Sayantanmukhuti/omni/Hardware/Basic/Milestones-Exhaustive-BOM.xlsx

Milestones Exhuastive BOM |  |  |  |  |  |  |  |  |  |  | Total | $742.06
BOM # | Comment | Designator | Description | Mounting Type | Package | Manufacturer | Manufacturer Part Number | Supplier | Supplier Part Number | Price per unit | Quantity | Total
 | DigiKey
1 | NRF52832_MODULE_MDBT42 |  | Bluetooth Bluetooth v4.2 Transceiver Module 2.4GHz Integrated, Chip Surface Mount | SMD | 41-SMD Module | Seeed Technology Co., Ltd | 317030213 | Digi-Key | 1597-1434-ND | $10.10 | 6 | $60.60
2 | ATmega328 |  | AVR AVR® ATmega Microcontroller IC 8-Bit 20MHz 32KB (16K x 16) FLASH 32-TQFP (7x7) | SMD | 32-TQFP (7x7) | Microchip Technology | ATMEGA328P-AUR | Digi-Key | ATMEGA328P-AURCT-ND | $2.14 | 1 | $2.14
3 | 0.96" OLED | OLED | Datasheet 128x64 OLED Module SPI 0.96"Graphic Displays,White on Black | SMD | Flexible Connector | EastRising | https://www.buydisplay.com/datasheet-128x64-oled-module-spi-0-96-inch-graphic-displays-white-on-black | BuyDisplay.com | https://www.buydisplay.com/datasheet-128x64-oled-module-spi-0-96-inch-graphic-displays-white-on-black | $2.51 | 1 | $75.30
4 | 8x8 Bright Blue LED Matrix | MATRIX | Small 1.2" 8x8 Ultra Bright Blue LED Matrix - KWM-30881CBB | THT | 16-Pin THT | Luckylight | KWM-30881CBB | Adafruit Industries | 1047 | $5.95 | 1 | $5.95
5 | FT231XS USB Serial |  | USB Bridge, USB to UART USB 2.0 UART Interface 20-SSOP | SMD | 20-SSOP | FTDI, Future Technology Devices International Ltd | FT231XS-U | Digi-Key | 768-1156-5-ND | $2.12 | 6 | $12.72
6 | FTDI |  | USB Bridge, USB to UART USB 2.0 UART Interface 20-SSOP | SMD | 20-SSOP | FTDI, Future Technology Devices International Ltd | FT231XS-U | Digi-Key | 768-1156-5-ND | $2.12 | 1 | $2.12 | $1.98 | $1.98
7 | CP2102N |  | USB Bridge, USB to UART USB 2.0 UART Interface 24-QFN (4x4) | SMD | 24-WFQFN (4mm x 4mm) Exposed Pad | Silicon Labs | CP2102N-A02-GQFN24 | Digi-Key | CP2102N-A02-GQFN24 | $1.35 | 1 | $1.35 | $1.25 | $1.25
8 | 350 mAh LiPo Battery |  | 3.7V Lithium Polymer Battery Rechargeable (Secondary) 350mAh | JST | JST PH Connector | Adafruit Industries LLC | 4237 | Digi-Key | 1528-4237-ND | $5.95 | 3 | $17.85
9 | 290 mAh LiPo Battery |  | 3.7V Lithium-Ion Battery Rechargeable (Secondary) 290mAh | JST | JST PH Connector | TinyCircuits | ASR00007 | Digi-Key | 1832-1032-ND | $5.95 | 3 | $17.85
10 | 350 mAh LiPo Battery |  | 3.7V Lithium-Ion Battery Rechargeable (Secondary) 350mAh | JST | JST PH Connector | Adafruit Industries LLC | 2750 | Digi-Key | 1528-1858-ND | $6.95 | 3 | $20.85
11 | 9V Battery Connector | 9V | Battery Connector, Snap 9V 1 Cell Wire Leads - 4" (101.6mm) | THT |  | Keystone Electronics | 81-4 | Digi-Key | 36-81-4-ND | $0.55 | 1 | $0.55 | $0.40 | $0.40
12 | PAM2401 Boost Converter |  | Boost Switching Regulator IC Positive Adjustable 2.5V 1 Output 1A 8-TSSOP, 8-MSOP (0.118", 3.00mm Width) | SMD | 8-MSOP | Diodes Incorporated | PAM2401SCADJ | Digi-Key | PAM2401SCADJDICT-ND | $1.05 | 1 | $1.05 | $0.68 | $0.68
13 | AP7312 1.8V/3.3V Dual LDO |  | Linear Voltage Regulator IC 2 Output 150mA, 150mA SOT-26 | SMD | SOT-23-6 | Diodes Incorporated | AP7312-1833W6-7 | Digi-Key | AP7312-1833W6-7DICT-ND | $0.59 | 1 | $0.59 | $0.37 | $0.37
14 | MIC5504-1.8V |  | Linear Voltage Regulator IC 1 Output 300mA SOT-23-5 | SMD | SOT23-5 | Microchip Technology | MIC5504-1.8YM5-TR | Digi-Key | 576-4879-1-ND | $0.11 | 1 | $0.11 | $0.08 | $0.08
15 | MIC5504-3.3V |  | Linear Voltage Regulator IC 1 Output 300mA SOT-23-5 | SMD | SOT23-5 | Microchip Technology | MIC5504-3.3YM5-TR | Digi-Key | 576-4764-1-ND | $0.11 | 1 | $0.11 | $0.08 | $0.08
16 | MIC5504 Voltage Regulator |  | Linear Voltage Regulator IC 1 Output 300mA SOT-23-5 | SMD | SOT23-5 | Microchip Technology | MIC5504-3.3YM5-TR | Digi-Key | 576-4764-1-ND | $0.11 | 10 | $1.10
17 | MCP73831 T Li-Ion, Li-Pol Controller |  | Charger IC Lithium-Ion/Polymer SOT-23-5 | SMD | SOT-23-5 | Microchip Technology | MCP73831T-2ACI/OT | Digi-Key | MCP73831T-2ACI/OTCT-ND | $0.56 | 10 | $5.60
18 | FT24C64A EEPROM |  | EEPROM Memory IC 64Kb (8K x 8) I²C 800kHz 1.2µs 8-SOP | SMD | 8-SOP | Fremont Micro Devices Ltd | FT24C64A-ESR-T | Digi-Key | 1219-1220-1-ND | $0.20 | 6 | $1.20
19 | LM358 |  | General Purpose Amplifier 2 Circuit 8-SOIC | SMD | 8-SOIC | Texas Instruments | LM358DR | Digi-Key | 296-1014-1-ND | $0.38 | 1 | $0.38 | $0.14 | $0.14
20 | MCP6001 |  | General Purpose Amplifier 1 Circuit Rail-to-Rail SOT-23-5 | SMD | SOT-23-5 | Microchip Technology | MCP6001T-E/OTCT-ND | Digi-Key | MCP6001T-E/OTCT-ND | $0.29 | 1 | $0.29 | $0.22 | $0.22
21 | Op Amp - MCP6004 |  | General Purpose Amplifier 4 Circuit Rail-to-Rail 14-SOIC | SMD | 14-SOIC | Microchip Technology | MCP6004T-I/SL | Digi-Key | MCP6004T-I/SLCT-ND | $0.44 | 6 | $2.64
22 | TIA |  | General Purpose Amplifier 1 Circuit Rail-to-Rail SOT-23-5 | SMD | SOT-23-5 | Microchip Technology | MCP6001T-I/OT | Digi-Key | MCP6001T-I/OTCT-ND | $0.24 | 6 | $1.44
23 | PCF8574 |  | I/O Expander 8 I²C 100kHz 16-SO | SMD | 16-SO | NXP USA Inc. | PCF8574AT/3,518 | Digi-Key | 568-1074-1-ND | $1.53 | 1 | $1.53
24 | Potentiometer |  | 500k Ohm 1 Gang Linear Panel Mount Potentiometer None 1 Kierros Conductive Plastic 0.25W, 1/4W PC Pins | THT | Panel Mount | Bourns Inc. | 3310Y-001-504L | Digi-Key | 3310Y-001-504L-ND | $2.90 | 1 | $2.90 | $2.11 | $2.11
25 | Potentiometer |  | 1M Ohm 1 Gang Linear Through Hole Potentiometer None 1 Kierros Carbon 0.08W PC Pins | THT | THT | Bourns Inc. | PDB12-M4251-105BF | Digi-Key | PDB12-M4251-105BF-ND | $1.02 | 1 | $1.02 | $0.75 | $0.75
26 | AD5242 |  | Digital Potentiometer 1M Ohm 2 Circuit 256 Taps I²C Interface 16-SOIC | SMD | 16-SOIC | Analog Devices Inc. | AD5242BRZ1M | Digi-Key | AD5242BRZ1M-ND | $3.47 | 6 | $20.82
27 | PCF8523 |  | Real Time Clock (RTC) IC Clock/Calendar I²C, 2-Wire Serial 8-SOIC (0.154", 3.90mm Width) | SMD | 8-SO | NXP USA Inc. | PCF8523T/1,118 | Digi-Key | 568-5306-1-ND | $1.26 | 6 | $7.56
28 | NPN-Generic |  | Bipolar (BJT) Transistor NPN 40V 600mA 300MHz 250mW Surface Mount TO-236AB | SMD | TO-236AB | Nexperia USA Inc. | PMBT2222A,215 | Digi-Key | 1727-2956-1-ND | $1.05 | 10 | $10.50
29 | NFET |  | N-Channel 30V 500mA (Ta) 690mW (Ta) Surface Mount SOT-23-3 (TO-236) | SMD | SOT23-3 | ON Semiconductor | NTR4003NT3G | Digi-Key | NTR4003NT3GOSCT-ND | $0.27 | 3 | $0.81 | $0.09 | $0.28
30 | CRYSTALECS-.327-12.5-12-C-TR (CRYSTAL) (32.7680kHz) |  | 32.768kHz ±10ppm Crystal 12.5pF 90 kOhms 2-SMD, No Lead | SMD | 2-SMD, No Lead | ECS Inc. | ECS-.327-12.5-12-C-TR | Digi-Key | XC2288CT-ND | $0.60 | 10 | $5.98
31 | 8 MHz Crystal (THT) |  | 8.388MHz ±30ppm Crystal 18pF 80 Ohms Cylindrical Can, Radial | THT | Cylindrical Can, Radial | EPSON | CA-301 8.388608M-C: PB FREE | Digi-Key | SER3415-ND | $0.83 | 1 | $0.83 | $0.61 | $0.61
32 | 8 MHz Crystal (SMD) |  | 8MHz ±30ppm Crystal 20pF 800 Ohms 4-SMD, No Lead | SMD | 4-SMD, No Lead | Raltron Electronics | RH100-8.000-20-3050-EXT-TR | Digi-Key | 2151-RH100-8.000-20-3050-EXT-TRCT-ND | $0.68 | 1 | $0.68 | $0.49 | $0.49
33 | 12.288 MHz Crystal (SMD) |  | 12.288MHz ±10ppm Crystal 20pF 150 Ohms 4-SMD, No Lead | SMD | 4-SMD.NO LEAD | Diodes Incorporated | FH1220004 | Digi-Key | FH1220004DICT-ND | $0.73 | 1 | $0.73 | $0.49 | $0.49
34 | 12.288 MHz Crystal (THT) |  | 12.288MHz ±30ppm Crystal 18pF 50 Ohms Cylindrical Can, Radial | THT | Cylindrical Can, Radial | EPSON | CA-301 12.2880M-C:PBFREE | Digi-Key | SER3426-ND | $0.83 | 1 | $0.83 | $0.61 | $0.61
35 | Cortex Debug Connector - 10 pin |  | Connector Header Through Hole 10 position 0.050" (1.27mm) | THT | NA | Amphenol ICC (FCI) | 20021111-00010T4LF | Digi-Key | 609-3712-ND | $0.69 | 6 | $4.14
36 | Schottky Diode |  | Diode Schottky 30V 1.5A Surface Mount USC | SMD | USC | Toshiba Semiconductor and Storage | CUS15S30,H3F | Digi-Key | CUS15S30H3FCT-ND | $0.26 | 25 | $6.40
37 | Green LED | LED1 | Green 525nm LED Indication - Discrete 3.1V 0805 (2012 Metric) | SMD | 0805 | QT Brightek (QTB) | QBLP631-IG | Digi-Key | 1516-1084-1-ND | $0.39 | 1 | $0.39
38 | Red LED |  | Red 622nm LED Indication - Discrete 2.2V 0603 (1608 Metric) | SMD | 0603 | Inolux | IN-S63ATR | Digi-Key | 1830-1065-1-ND | $0.18 | 20 | $3.54
39 | Blue LED |  | Blue 470nm LED Indication - Discrete 3V 0603 (1608 Metric) | SMD | 0603 | Inolux | IN-S63AT5B | Digi-Key | 1830-1061-1-ND | $0.18 | 20 | $3.54
40 | Yellow LED |  | Yellow 590nm LED Indication - Discrete 2V 0603 (1608 Metric) | SMD | 0603 | Wurth Electronics Inc. | 150060YS75000 | Digi-Key | 732-4981-1-ND | $0.14 | 20 | $2.80
41 | White LED | LED1 | White LED Indication - Discrete 2.9V Radial | THT | Radial | American Bright Optoelectronics Corporation | BL-BZX3V4V-1-B02 | Digi-Key | BL-BZX3V4V-1-B02-ND | $0.26 | 1 | $0.26 | $0.09 | $0.09
42 | DotStar LED Matrix |  | SparkFun LuMini LED Matrix | SMD | Unspecified | SparkFun Electronics | COM-15047 | Digi-Key | 1568-COM-15047-ND | $25.95 | 1 | $25.95 | $25.95 | $25.95
43 | 16-Channel Multiplexer |  | Circuit IC Switch 16:1 160Ohm 24-SOIC | SMD | 24-SOIC | Texas Instruments | CD74HC4067M96 | Digi-Key | 296-29408-1-ND | $0.80 | 1 | $0.80 | $0.54 | $0.54
44 | 16-Channel Multiplexer |  | Circuit IC Switch 16:1 160Ohm 24-SSOP | SMD | 24-SSOP | Texas Instruments | CD74HC4067SM96E4 | Digi-Key | 296-52634-1-ND | $0.83 | 1 | $0.83 | $0.56 | $0.56
45 | PCF8575DWR |  | I/O Expander 16 I²C, SMBus 24-SOIC | SMD | 24-SOIC | Texas Instruments | PCF8575DWR | Digi-Key | 296-20981-1-ND | $2.52 | 1 | $2.52 | $1.82 | $1.82
46 | PCF8574ADWR |  | I/O Expander 8 I²C 16-SOIC | SMD | 16-SOIC | Texas Instruments | PCF8574DWR | Digi-Key | 296-13108-1-ND | $1.72 | 1 | $1.72 | $1.12 | $1.12
47 | Rotary Encoder |  | Rotary Encoder Mechanical 12 Quadrature (Incremental) Right Angle | THT | PC Pins | Bourns Inc. | PEC09-2220F-S0012 | Digi-Key | PEC09-2220F-S0012-ND | $3.16 | 1 | $3.16 | $2.15 | $2.15
48 | Electret Microphone | MIC | 100Hz ~ 10kHz Analog Microphone Electret Condenser Omnidirectional (-42dB ±3dB @ 94dB SPL) PC Pins | THT | PC Pins | CUI Devices | CMEJ-0415-42-P | Digi-Key | 102-6542-ND | $0.40 | 1 | $0.40 | $0.28 | $0.28
49 | Photodiode | PD | Photodiode 940nm 100ns 130° 2-SMD, Gull Wing, PHOTODIODE PIN HI SPEED HI SENS | SMD | 2-SMD, Gull Wing | Vishay Semiconductor Opto Division | VBPW34S | Digi-Key | 751-1500-1-ND | $1.19 | 1 | $1.19
50 | Photoresistor | Photo | CDS Cell 520nm 27 ~ 60kOhms @ 10 lux | THT | Radial | Advanced Photonix | PDV-P8104 | Digi-Key | PDV-P8104-ND | $0.89 | 1 | $0.89 | $0.46 | $0.46
51 | Ambient Light Sensor |  | Optical Sensor Ambient 630nm Analog 0603 (1608 Metric) | SMD | 0603 | Inolux | IN-S63DTLS | Digi-Key | 1830-IN-S63DTLSCT-ND | $0.55 | 1 | $0.55 | $0.26 | $0.26
52 | Thermistor |  | NTC Thermistor 10k 0603 (1608 Metric) | SMD | 0603 | Murata Electronics | NCU18XH103F60RB | Digi-Key | 490-16279-1-ND | $0.12 | 1 | $0.12 | $0.06 | $0.06
53 | Thermistor |  | NTC Thermistor 10k 0402 (1005 Metric) | SMD | 0402 | TDK Corporation | NTCG103JF103FT1 | Digi-Key | 445-2550-1-ND | $0.10 | 1 | $0.10 | $0.06 | $0.06
54 | 2.1 uH NFC Antenna |  | NFC ANTENNA 15.00MM BY 15.00MM B |  |  | Molex | 1462360151 | Digi-Key | 900-1462360151-ND | $1.38 | 2 | $2.76
55 | SWITCH.MOM (TACTILE_SWITCH_SMD_6.2MM_TALL) |  | Tactile Switch SPST-NO Top Actuated Surface Mount - TACT 4.5 X 4.5, 3.8 MM H, 1.8N, | SMD | Gull Wing | C&K | PTS 647 SM38 SMTR2 LFS | Digi-Key | PTS647SM38SMTR2LFSCT-ND | $0.12 | 25 | $3.02
56 | SWITCH.MOM (TACTILE_SWITCH_SMD_6.2MM_TALL) |  | Tactile Switch SPST-NO Top Actuated Surface Mount - TACT 4.5 X 4.5, 5.0 MM H, 1.0N, | SMD | Gull Wing | C&K | PTS 647 SN50 SMTR2 LFS | Digi-Key | PTS647SN50SMTR2LFSCT-ND | $0.12 | 25 | $3.02
57 | SWITCH.MOM (TACTILE_SWITCH_SMD_6.2MM_TALL) |  | Tactile Switch SPST-NO Top Actuated Surface Mount - TACT 4.5 X 4.5, 7.0 MM H, 1.0N, | SMD | Gull Wing | C&K | PTS 647 SN70 SMTR2 LFS | Digi-Key | PTS647SN70SMTR2LFSCT-ND | $0.12 | 25 | $3.02
58 | DFU SPST-PTS830GG140 |  | Tactile Switch SPST-NO Top Actuated Surface Mount | SMD | Gull Wing | C&K Components | PTS830GM140 SMTR LFS | Digi-Key | CKN10587CT-ND | $0.53 | 25 | $13.14
59 | Micro USB |  | USB - micro B USB 2.0 Receptacle Connector 5 Position Surface Mount, Right Angle | SMD | Flange, Horizontal | Amphenol FCI | 10118192-0001LF | Digi-Key | 609-4613-1-ND | $0.43 | 10 | $4.30
60 | SD Card Slot |  | 8 Position Card Connector Secure Digital - microSD™ Surface Mount, Right Angle Gold | SMD | NA | Molex | 0473340001 | Digi-Key | WM3288CT-ND | $3.64 | 5 | $18.20
61 | 2x3 Male Pin Headers |  | Connector Header Through Hole 6 position 0.100" (2.54mm) | THT |  | Adam Tech | PH2-06-UA | Digi-Key | 2057-PH2-06-UA-ND | $0.12 | 1 | $0.12 | $0.07 | $0.07
62 | CONN_07-1.27MM (CONN_07) |  | 50 Position Header Connector 0.050" (1.27mm) Through Hole Gold | THT |  | Sullins Connector Solutions | LPPB501NFFN-RC | Digi-Key | S9008E-50-ND | $5.06 | 5 | $25.30
63 | CONN_07-1.27MM |  | 50 Positions Header Connector 0.050" (1.27mm) Through Hole Gold | THT |  | Sullins Connector Solutions | GRPB501VWVN-RC | Digi-Key | S9014E-50-ND | $3.11 | 5 | $15.55
64 | Bigger Button |  | Tactile Switch SPST-NO Top Actuated Surface Mount | SMD | Gull Wing | C&K | PTS645SM43SMTR92 LFS | Digi-Key | CKN9112CT-ND | $0.25 | 1 | $0.25 |  | $0.00
65 | Tiny Rectangular Switch |  | Tactile Switch SPST-NO Top Actuated Surface Mount | SMD | Gull Wing | C&K Components | PTS830GM140 SMTR LFS | Digi-Key | CKN10587CT-ND | $0.57 | 1 | $0.57 |  | $0.00
66 | SAM-M8Q U-Blox GPS |  | SAM-M8Q RF Receiver Galileo, GLONASS, GPS 1.575GHz, 1.602GHz -165dBm 400kbps | SMD | Module | U-Blox | SAM-M8Q-0-10 | Digi-Key | 672-1054-1-ND | $25.00 | 1 | $25.00 | $13.26 | $13.26
67 | GP-20U7 GPS Module |  | GPS Modules GPS Receiver GP-20U7 | SMD | Module | SparkFun | GPS-13740 | Mouser | 474-GPS-13740 | $19.04 | 1 | $19.04 | $19.04 | $19.04
68 | Mini Speaker |  | 8 Ohms General Purpose Speaker 500mW 300Hz ~ 8kHz Top Round | THT | Wire Leads | Soberton Inc. | SP-1303L | Digi-Key | 433-1204-ND | $1.71 | 1 | $1.71 | $1.16 | $1.16
69 | Vibration Motor |  | DC Motor Vibration, ERM 10000 RPM 3VDC | THT | Wire Leads | Jinlong Machinery & Electronics, Inc. | C0720B015F | Digi-Key | 1670-1030-ND | $3.54 | 1 | $3.54 | $2.61 | $2.61
70 | 10µH Inductor |  | 10µH Shielded Multilayer Inductor 250mA 1.05Ohm 0603 (1608 Metric) | SMD | 0603 | TDK Corporation | MLZ1608M100WTD25 | Digi-Key | MLZ1608M100WTD25 | $0.22 | 1 | $0.22 | $0.13 | $0.13
71 | 10µH Inductor |  | 10µH Shielded Multilayer Inductor 350mA 470mOhm 0805 (2012 Metric) | SMD | 0805 | TDK Corporation | MLZ2012M100WT000 | Digi-Key | 445-6396-1-ND | $0.14 | 1 | $0.14 | $0.09 | $0.09
72 | 0 ohm resistor (not sure if needed) |  | 0 Ohms Jumper 0.1W, 1/10W Chip Resistor 0603 (1608 Metric) Moisture Resistant Thick Film | SMD | 0603 | Yageo | RC0603JR-070RL | Digi-Key | 311-0.0GRCT-ND | $0.01 | 100 | $0.70
73 | 27 ohm resistor |  | 27 Ohms ±1% 0.1W, 1/10W Chip Resistor 0603 (1608 Metric) Automotive AEC-Q200 Thick Film | SMD | 0603 | Stackpole Electronics Inc | RMCF0603FT27R0 | Digi-Key | RMCF0603FT27R0CT-ND | $0.01 | 100 | $0.59
74 | 1k Resistor |  | 1 kOhms ±1% 0.1W, 1/10W Chip Resistor 0603 (1608 Metric) Automotive AEC-Q200 Thick Film | SMD | 0603 | Stackpole Electronics Inc | RMCF0603FT1K00 | Digi-Key | RMCF0603FT1K00CT-ND | $0.01 | 100 | $0.59
75 | 4.7k resistor |  | 4.7 kOhms ±1% 0.1W, 1/10W Chip Resistor 0603 (1608 Metric) Automotive AEC-Q200 Thick Film | SMD | 0603 | Stackpole Electronics Inc | RMCF0603FT4K70 | Digi-Key | RMCF0603FT4K70CT-ND | $0.01 | 100 | $0.59
76 | 10k Resistor |  | 10 kOhms ±1% 0.1W, 1/10W Chip Resistor 0603 (1608 Metric) Automotive AEC-Q200 Thick Film | SMD | 0603 | Stackpole Electronics Inc | RMCF0603FT10K0 | Digi-Key | RMCF0603FT10K0CT-ND | $0.01 | 100 | $0.59
77 | 100k Resistor |  | 100 kOhms ±1% 0.1W, 1/10W Chip Resistor 0603 (1608 Metric) Automotive AEC-Q200 Thick Film | SMD | 0603 | Stackpole Electronics Inc | RMCF0603FT100K | Digi-Key | RMCF0603FT100KCT-ND | $0.01 | 100 | $0.59
78 | 220k resistor |  | 220 kOhms ±1% 0.1W, 1/10W Chip Resistor 0603 (1608 Metric) Automotive AEC-Q200 Thick Film | SMD | 0603 | Stackpole Electronics Inc | RMCF0603FT220K | Digi-Key | RMCF0603FT220KCT-ND | $0.01 | 100 | $0.59
79 | 390k resistor |  | 390 kOhms ±1% 0.1W, 1/10W Chip Resistor 0603 (1608 Metric) Automotive AEC-Q200 Thick Film | SMD | 0603 | Stackpole Electronics Inc | RMCF0603FG390K | Digi-Key | RMCF0603FG390KCT-ND | $0.01 | 100 | $0.59
80 | 1M Resistor |  | 1 MOhms ±1% 0.1W, 1/10W Chip Resistor 0603 (1608 Metric) Automotive AEC-Q200 Thick Film | SMD | 0603 | Stackpole Electronics Inc | RMCF0603FT1M00 | Digi-Key | RMCF0603FT1M00CT-ND | $0.01 | 100 | $0.59
81 | 10M Resistor |  | 10 MOhms ±1% 0.1W, 1/10W Chip Resistor 0603 (1608 Metric) Automotive AEC-Q200 Thick Film | SMD | 0603 | Stackpole Electronics Inc | RMCF0603FT10M0 | Digi-Key | RMCF0603FT10M0CT-ND | $0.01 | 100 | $0.89
82 | 22M Resistor |  | 22 MOhms ±5% 0.1W, 1/10W Chip Resistor 0603 (1608 Metric) Automotive AEC-Q200, Moisture Resistant Thick Film | SMD | 0603 | KOA Speer Electronics, Inc. | RK73B1JTTD226J | Digi-Key | 2019-RK73B1JTTD226JCT-ND | $0.01 | 100 | $0.53
83 | 12pF capacitor |  | 12pF ±5% 50V Ceramic Capacitor C0G, NP0 0603 (1608 Metric) | SMD | 0603 | Walsin Technology Corporation | 0603N120J500CT | Digi-Key | 1292-1480-1-ND | $0.01 | 100 | $1.19
84 | 18pF capacitor |  | 18pF ±5% 50V Ceramic Capacitor C0G, NP0 0603 (1608 Metric) | SMD | 0603 | Walsin Technology Corporation | 0603N180J500CT | Digi-Key | 1292-1494-1-ND | $0.10 | 1 | $0.10 | 0.0119 | 100
85 | 33pF capacitor |  | 33pF ±5% 50V Ceramic Capacitor C0G, NP0 0603 (1608 Metric) | SMD | 0603 | Walsin Technology Corporation | 0603N330J500CT | Digi-Key | 1292-1645-1-ND | $0.10 | 1 | $0.10 | 0.0119 | 100
86 | 47 pF Capacitor |  | 47pF ±5% 50V Ceramic Capacitor C0G, NP0 0603 (1608 Metric) | SMD | 0603 | Walsin Technology Corporation | 0603N470J500CT | Digi-Key | 1292-1528-1-ND | $0.01 | 100 | $1.10
87 | 120 pF Capacitor |  | 120pF ±5% 50V Ceramic Capacitor C0G, NP0 0603 (1608 Metric) | SMD | 0603 | Walsin Technology Corporation | 0603N121J500CT | Digi-Key | 1292-1481-1-ND | $0.02 | 100 | $1.75
88 | 2.2n Capacitor |  | 2200pF ±10% 50V Ceramic Capacitor X7R 0603 (1608 Metric) | SMD | 0603 | Walsin Technology Corporation | 0603B222K500CT | Digi-Key | 1292-1412-1-ND | $0.01 | 100 | $1.16
89 | 22n capacitor |  | 0.022µF ±10% 50V Ceramic Capacitor X7R 0603 (1608 Metric) | SMD | 0603 | Samsung Electro-Mechanics | CL10B223KB8NNNC | Digi-Key | 1276-1104-1-ND | $0.02 | 100 | $1.56
90 | 100 nF Capacitor |  | 0.1µF ±5% 16V Ceramic Capacitor X7R 0603 (1608 Metric) | SMD | 0603 | Yageo | CC0603JRX7R7BB104 | Digi-Key | 311-1776-1-ND | $0.03 | 100 | $3.31
91 | 1uF capacitor |  | 1µF ±10% 25V Ceramic Capacitor X5R 0603 (1608 Metric) | SMD | 0603 | Samsung Electro-Mechanics | CL10A105KA8NNNC | Digi-Key | 1276-1102-1-ND | $0.10 | 1 | $0.10 | $0.02 | $0.02
92 | 2.2u capacitor |  | 2.2µF ±10% 16V Ceramic Capacitor X5R 0603 (1608 Metric) | SMD | 0603 | Samsung Electro-Mechanics | CL10A225KO8NNNC | Digi-Key | 1276-1040-1-ND | $0.03 | 100 | $3.16 |  | $0.00
93 | 4.7 uF Capacitor |  | red 622nm LED Indication - Discrete 2.2V 0603 (1608 Metric) | SMD | 0603 | Samsung Electro-Mechanics | CL10A475KO8NNNC | Digi-Key | 1276-1784-1-ND | $0.04 | 100 | $4.40 |  | $0.00
94 | 10 uF 0603 Capacitor |  | 10µF ±10% 10V Ceramic Capacitor X5R 0603 (1608 Metric) | SMD | 0603 | Murata Electronics | GRM188R61A106KE69J | Digi-Key | 490-14372-1-ND | $0.06 | 100 | $6.32 |  | $0.00
95 | 22u capacitor |  | 22µF ±20% 10V Ceramic Capacitor X5R 0603 (1608 Metric) | SMD | 0603 | Samsung Electro-Mechanics | CL10A226MP8NUNE | Digi-Key | 1276-1274-1-ND | $0.07 | 100 | $6.72 |  | $0.00
96 | Adafruit Feather nRF52 |  | - Transceiver; Bluetooth® Smart 4.x Low Energy (BLE) For Use With nRF52832 | NA | NA | Adafruit Industries LLC | 3406 | Digi-Key | 1528-2095-ND | $24.95 | 3 | $74.85 |  | $0.00
97 | J-LINK EDU |  | JTAG EMULATOR FOR ARM CORES - ARM7®, ARM9®, Cortex® - Emulator | NA | NA | Segger Microcontroller Systems | 8.08.90 J-LINK EDU | Digi-Key | 899-1008-ND | $63.75 | 1 | $63.75 |  | $0.00
98 | J-LINK 9-PIN CORTEX-M ADAPTER |  | Cortex®-M Devices - Adapter Board - J-LINK 9-PIN CORTEX-M ADAPTER | NA | NA | Segger Microcontroller Systems | 8.06.02 J-LINK 9-PIN CORTEX-M ADAPTER | Digi-Key | 899-1012-ND | $31.88 | 1 | $31.88 |  | $0.00
99 |  |  |  |  |  |  |  |  |  |  |  |  |  | $0.00
100 | JST Connector |  | JST Right Angle Connector - White | SMD | NA | 4UCOM Technology Inc. |  | Sparkfun Electronics | PRT-08612 | $0.95 | 1 | $0.95 |  | $0.00 | $0.90 | $0.86 | $0.86 | $0.86 | $0.86 | $0.90 | $0.86 | $0.86 | $0.86 | $0.86 | $22.50 | $86.00 | $215.00 | $430.00 | $860.00
101 | Switch |  | SWITCH SLIDE DPDT 300MA 6V | SMD | J Lead | C&K | JS202011JCQN | Digi-Key | CKN10723CT-ND | $0.48 | 2 | $0.96 |  | $0.00 | $0.45 | $0.39 | $0.37 | $0.32 | $0.32 | $0.90 | $0.77 | $0.75 | $0.64 | $0.64 | $22.62 | $77.00 | $186.78 | $317.62 | $635.24
102 | Right Angle, 6Pos Male Headers |  | 40 Positions Header, Breakaway Connector 0.100" (2.54mm) Through Hole, Right Angle Gold | THT |  | Sullins Connector Solutions | PRPC040SBAN-M71RC | Digi-Key | S1111EC-40-ND | $0.14 | 1 | $0.14 |  | $0.00 | $0.12 | $0.10 | $0.10 | $0.08 | $0.07 | $0.12 | $0.10 | $0.10 | $0.08 | $0.07 | $3.08 | $10.14 | $25.36 | $40.09 | $68.83
103 | 8MHz Crystal |  | 8MHz ±30ppm Crystal 18pF 80 Ohm -20°C ~ 70°C Through Hole Cylindrical Can, Radial | THT | Cylindrical Can, Radial | EPSON | CA-301 8.0000M-C:PBFREE | Digi-Key | SER3414-ND | $0.83 | 1 | $0.83 |  | $0.00 | $0.74 | $0.61 | $0.61 | $0.58 | $0.48 | $0.74 | $0.61 | $0.61 | $0.58 | $0.48 | $18.40 | $60.80 | $152.00 | $288.00 | $480.00
104 | Square Button |  | Tactile Switch SPST-NO Top Actuated Surface Mount | SMD | Gull Wing | C&K | PTS645SM43SMTR92 LFS | Digi-Key | CKN9112CT-ND | $0.15 | 3 | $0.45 |  | $0.00 | $0.14 | $0.13 | $0.12 | $0.12 | $0.12 | $0.42 | $0.39 | $0.36 | $0.35 | $0.35 | $10.62 | $38.70 | $91.08 | $174.57 | $349.14
105 | Tiny Rectangular Button |  | Tactile Switch SPST-NO Top Actuated Surface Mount | SMD | Gull Wing | C&K Components | PTS830GM140 SMTR LFS | Digi-Key | CKN10587CT-ND | $0.56 | 1 | $0.56 |  | $0.00 | $0.53 | $0.44 | $0.40 | $0.38 | $0.30 | $0.53 | $0.44 | $0.40 | $0.38 | $0.30 | $13.34 | $44.29 | $100.65 | $191.24 | $301.95
106 | 5mm Radial Green LED, Diffused |  | Green 570nm LED Indication - Discrete 2.2V Radial | THT | Radial | Visual Communications Company - VCC | VAOL-5LDE1 | Digi-Key | VAOL-5LDE1-ND | $0.43 | 1 | $0.43 |  | $0.00 | $0.25 | $0.20 | $0.17 | $0.14 | $0.11 | $0.25 | $0.20 | $0.17 | $0.14 | $0.11 | $6.30 | $20.16 | $42.53 | $72.45 | $113.40
107 | Green LED |  | Green 571 nm, 2 V | SMD | 0603 | Lite-On Inc | LTST-C190KGKT | Digi-Key | 160-1435-1-ND | $0.27 | 3 | $0.81 |  | $0.00 | $0.14 | $0.10 | $0.07 | $0.06 | $0.05 | $0.43 | $0.31 | $0.21 | $0.19 | $0.15 | $10.86 | $31.02 | $52.74 | $93.06 | $145.80
108 | 2.2uF capacitor |  | 2.2µF ±10% 16V Ceramic Capacitor X5R 0603 (1608 Metric) | SMD | 0603 | Murata Electronics North America | GRM188R61C225KE15D | Digi-Key | 490-3296-1-ND | $0.13 | 2 | $0.26 |  | $0.00 | $0.09 | $0.04 | $0.04 | $0.03 | $0.03 | $0.19 | $0.09 | $0.09 | $0.06 | $0.05 | $4.70 | $8.80 | $22.00 | $30.86 | $51.10
109 |  |  |  |  |  |  |  |  |  |  |  |  |  | $0.00
110 | Red 8x8 LED Matrix |  | Small 1.2" 8x8 Ultra Bright Red LED Matrix - KWM-30881CVB | THT | 16-Pin THT | Luckylight | KWM-30881CVB | Adafruit Industries | 455 | $3.95 | 1 | $3.95 |  | $0.00 | $3.56 | $3.16 | $3.16 | $3.16 | $3.16
111 | Yellow-Orange LED Matrix |  | Small 1.2" 8x8 Ultra Bright Yellow-Orange LED Matrix - KWM-30881CUYB | THT | 16-Pin THT | Luckylight | KWM-30881CUYB | Adafruit Industries | 1046 | $4.50 | 1 | $4.50 |  | $0.00 | $4.05 | $3.60 | $3.60 | $3.60 | $3.60
112 | Yellow-Green LED Matrix |  | Small 1.2" 8x8 Ultra Bright Yellow-Green LED Matrix - KWM-30881CUGB | THT | 16-Pin THT | Luckylight | KWM-30881CUGB | Adafruit Industries | 1045 | $4.95 | 1 | $4.95 |  | $0.00 | $4.46 | $3.96 | $3.96 | $3.96 | $3.96
113 | White LED Matrix |  | Small 1.2" 8x8 Ultra Bright White LED Matrix - KWM-30881CWB | THT | 16-Pin THT | Luckylight | KWM-30881CWB | Adafruit Industries | 1613 | $7.50 | 1 | $7.50 |  | $0.00 | $6.75 | $6.00 | $6.00 | $6.00 | $6.00
114 | Green LED Matrix |  | Small 1.2" 8x8 Ultra Bright Pure Green LED Matrix - KWM-30881CPGB | THT | 16-Pin THT | Luckylight | KWM-30881CPGB | Adafruit Industries | 1623 | $4.95 | 1 | $4.95 |  | $0.00 | $4.46 | $3.96 | $3.96 | $3.96 | $3.96
115 | APDS-9008 |  | Optical Sensor Ambient 565nm Current 6-SMD, No Lead | SMD | 6-SMD, No Lead | Broadcom Limited | APDS-9008-020 | Digi-Key | 516-2662-1-ND | $1.04 | 1 | $4.95 | $0.70 | $0.70
 |  |  |  |  |  |  |  |  |  |  |  |  |  | $0.00
 |  |  |  |  |  |  |  |  |  |  |  |  |  | $0.00
 |  |  |  |  |  |  |  |  |  |  |  |  |  | $0.00
 |  |  |  |  |  |  |  |  |  |  |  |  |  | $0.00
 |  |  |  |  |  |  |  |  |  |  |  |  |  | $0.00
 |  |  |  |  |  |  |  |  |  |  |  |  |  | $0.00
 |  |  |  |  |  |  |  |  |  |  |  |  |  | $0.00
 |  |  |  |  |  |  |  |  |  |  |  |  |  | $0.00
 |  |  |  |  |  |  |  |  |  |  |  |  |  | $0.00
 | Mouser |  |  |  |  |  |  |  |  |  |  |  |  | $0.00
1 | AD5171 |  | Digital Potentiometer ICs IC 6-Bit OTP I2C | SMD | SOT-23-8 | Analog Devices | AD5171BRJZ100-R7 | Mouser | 584-AD5171BRJZ100-R7 | $2.68 | 5 | $13.40 |  | $0.00
 |  |  |  |  |  |  |  |  |  |  |  |  |  | $0.00
 |  |  |  |  |  |  |  |  |  |  |  |  |  | $0.00
 |  |  |  |  |  |  |  |  |  |  |  |  |  | $0.00
 | SparkFun Electronics |  |  |  |  |  |  |  |  |  |  |  |  | $0.00
1 | Mini Speaker |  | Mini Speaker - PC Mount 12mm 2.048kHz | THT | PC Mount | CUI Inc | COM-07950 | SparkFun Electronics | COM-07950 | $1.95 | 1 | $1.95 | $1.76 | $1.76
 |  |  |  |  |  |  |  |  |  |  |  |  |  | $0.00
 |  |  |  |  |  |  |  |  |  |  |  |  |  | $0.00
 |  |  |  |  |  |  |  |  |  |  |  |  |  | $0.00
 | Amazon |  |  |  |  |  |  |  |  |  |  |  |  | $0.00
1 | Red Laser | LASER | HiLetgo 10pcs 5V 650nm 5mW Red Dot Laser Head Red Laser Diode Laser Tube with Leads Head Outer Diameter 6mm | THT | Wire Leads | HiLetgo |  | HiLetgo on Amazon | B071FT9HSV | $0.55 | 1 | $0.55 | $0.55 | $0.55
 |  |  |  |  |  |  |  |  |  |  |  |  |  | $0.00
 |  |  |  |  |  |  |  |  |  |  |  |  |  | $0.00
 |  |  |  |  |  |  |  |  |  |  |  |  |  | $0.00
 | Custom Order |  |  |  |  |  |  |  |  |  |  |  |  | $0.00
1 | LSM6DS3 castellated breakout |  |  |  |  |  |  |  |  |  |  | $0.00 |  | $0.00
 |  |  |  |  |  |  |  |  |  |  |  |  |  | $0.00
 |  |  |  |  |  |  |  |  |  |  |  |  |  | $0.00
 |  |  |  |  |  |  |  |  |  |  |  |  |  | $0.00
 |  |  |  |  |  |  |  |  |  |  |  |  |  | $0.00
 |  |  |  |  |  |  |  |  |  |  |  |  |  | $0.00
 |  |  |  |  |  |  |  |  |  |  |  |  |  | $0.00
 |  |  |  |  |  |  |  |  |  |  |  |  |  | $0.00
 |  |  |  |  |  |  |  |  |  |  |  |  |  | $0.00
 |  |  |  |  |  |  |  |  |  |  |  |  |  | $0.00
