Sayantanmukhuti/omni/Hardware/Basic/Top/Omni-BASIC-TOP-BOM.xlsx

Omni Basic Top Board Rev A / Purdue Milestones |  |  |  |  |  |  |  |  |  |  | Total | $101.41 | Total (in Bulk) | $0.19
BOM # | Comment | Designator | Description | Mounting Type | Package | Manufacturer |  |  |  | Price per unit | Quantity | Total | Per 100 | Total
1 | 1uF capacitor | C1, C3, C6 | 1µF ±10% 25V Ceramic Capacitor X5R 0603 (1608 Metric) | SMD | 0603 | Samsung Electro-Mechanics |  |  |  | $0.10 | 3 | $0.30 | $0.02 | $0.06
2 | 4.7 uF Capacitor | C1, C7 | red 622nm LED Indication - Discrete 2.2V 0603 (1608 Metric) | SMD | 0603 | Samsung Electro-Mechanics |  |  |  | $0.04 | 2 | $0.09 |  | $0.00
3 | 10 uF 0603 Capacitor | C4, C16 | 10µF ±10% 10V Ceramic Capacitor X5R 0603 (1608 Metric) | SMD | 0603 | Murata Electronics |  |  |  | $0.06 | 2 | $0.13 |  | $0.00
4 | 12pF capacitor | C5, C8 | 12pF ±5% 50V Ceramic Capacitor C0G, NP0 0603 (1608 Metric) | SMD | 0603 | Walsin Technology Corporation |  |  |  | $0.01 | 2 | $0.02 |  | $0.00
5 | 47 pF Capacitor | C11, C13 | 47pF ±5% 50V Ceramic Capacitor C0G, NP0 0603 (1608 Metric) | SMD | 0603 | Walsin Technology Corporation |  |  |  | $0.01 | 2 | $0.02 |  | $0.00
6 | 100 nF Capacitor | C12, C14 | 0.1µF ±5% 16V Ceramic Capacitor X7R 0603 (1608 Metric) | SMD | 0603 | Yageo |  |  |  | $0.03 | 2 | $0.07 |  | $0.00
7 | 2.2u capacitor | C17, C18, C19, C20, C21 | 2.2µF ±10% 16V Ceramic Capacitor X5R 0603 (1608 Metric) | SMD | 0603 | Samsung Electro-Mechanics |  |  |  | $0.03 | 5 | $0.16 |  | $0.00
8 | MCP73831 T Li-Ion, Li-Pol Controller | CHRG1 | Charger IC Lithium-Ion/Polymer SOT-23-5 | SMD | SOT-23-5 | Microchip Technology |  |  |  | $0.56 | 1 | $0.56 |  | $0.00
9 | Schottky Diode | D1, D2, D3 | Diode Schottky 30V 1.5A Surface Mount USC | SMD | USC | Toshiba Semiconductor and Storage |  |  |  | $0.26 | 3 | $0.77 |  | $0.00
10 | Cortex Debug Connector - 10 pin | DEBUG1 CORTEX_DEBUG_PTH | Connector Header Through Hole 10 position 0.050" (1.27mm) | THT | NA | Amphenol ICC (FCI) |  |  |  | $0.69 | 1 | $0.69 |  | $0.00
11 | 10µH Inductor | L1 | 10µH Shielded Multilayer Inductor 250mA 1.05Ohm 0603 (1608 Metric) | SMD | 0603 | TDK Corporation |  |  |  | $0.22 | 1 | $0.22 | $0.13 | $0.13
12 | MIC5504 Voltage Regulator | LD01 | Linear Voltage Regulator IC 1 Output 300mA SOT-23-5 | SMD | SOT23-5 | Microchip Technology |  |  |  | $0.11 | 1 | $0.11 |  | $0.00
13 | Red LED | LED1, LED3 | Red 622nm LED Indication - Discrete 2.2V 0603 (1608 Metric) | SMD | 0603 | Inolux |  |  |  | $0.18 | 2 | $0.35 |  | $0.00
14 | Blue LED | LED2 | Blue 470nm LED Indication - Discrete 3V 0603 (1608 Metric) | SMD | 0603 | Inolux |  |  |  | $0.18 | 1 | $0.18 |  | $0.00
15 | Yellow LED | LED4 | Yellow 590nm LED Indication - Discrete 2V 0603 (1608 Metric) | SMD | 0603 | Wurth Electronics Inc. |  |  |  | $0.14 | 1 | $0.14 |  | $0.00
16 | 10k Resistor | R1, R2, R10, R13 | 10 kOhms ±1% 0.1W, 1/10W Chip Resistor 0603 (1608 Metric) Automotive AEC-Q200 Thick Film | SMD | 0603 | Stackpole Electronics Inc |  |  |  | $0.01 | 4 | $0.02 |  | $0.00
17 | 100k Resistor | R3, R6, R7 | 100 kOhms ±1% 0.1W, 1/10W Chip Resistor 0603 (1608 Metric) Automotive AEC-Q200 Thick Film | SMD | 0603 | Stackpole Electronics Inc |  |  |  | $0.01 | 3 | $0.02 |  | $0.00
18 | 1k Resistor | R8, R9, R14, R16 | 1 kOhms ±1% 0.1W, 1/10W Chip Resistor 0603 (1608 Metric) Automotive AEC-Q200 Thick Film | SMD | 0603 | Stackpole Electronics Inc |  |  |  | $0.01 | 4 | $0.02 |  | $0.00
19 | 27 ohm resistor | R11, R12 | 27 Ohms ±1% 0.1W, 1/10W Chip Resistor 0603 (1608 Metric) Automotive AEC-Q200 Thick Film | SMD | 0603 | Stackpole Electronics Inc |  |  |  | $0.01 | 2 | $0.01 |  | $0.00
20 | 390k resistor | R15 | 390 kOhms ±1% 0.1W, 1/10W Chip Resistor 0603 (1608 Metric) Automotive AEC-Q200 Thick Film | SMD | 0603 | Stackpole Electronics Inc |  |  |  | $0.01 | 1 | $0.01 |  | $0.00
21 | Tiny Rectangular Button | RESET, SW1 | Tactile Switch SPST-NO Top Actuated Surface Mount | SMD | Gull Wing | C&K Components |  |  |  | $0.56 | 2 | $0.56 |  | $0.00
22 | SWITCH.MOM (TACTILE_SWITCH_SMD_6.2MM_TALL) | SW2, SW3 | Tactile Switch SPST-NO Top Actuated Surface Mount - TACT 4.5 X 4.5, 3.8 MM H, 1.8N, | SMD | Gull Wing | C&K |  |  |  | $0.12 | 2 | $0.24 |  | $0.00
23 | NRF52832_MODULE_MDBT42 | U1 | Bluetooth Bluetooth v4.2 Transceiver Module 2.4GHz Integrated, Chip Surface Mount | SMD | 41-SMD Module | Seeed Technology Co., Ltd |  |  |  | $10.10 | 1 | $10.10 |  | $0.00
24 | FT231XS USB Serial | U3 | USB Bridge, USB to UART USB 2.0 UART Interface 20-SSOP | SMD | 20-SSOP | FTDI, Future Technology Devices International Ltd |  |  |  | $2.12 | 1 | $2.12 |  | $0.00
25 | 0.96" OLED | U4 | Datasheet 128x64 OLED Module SPI 0.96"Graphic Displays,White on Black | SMD | Flexible Connector | EastRising | https://www.buydisplay.com/datasheet-128x64-oled-module-spi-0-96-inch-graphic-displays-white-on-black | http://buydisplay.com/ | https://www.buydisplay.com/datasheet-128x64-oled-module-spi-0-96-inch-graphic-displays-white-on-black | $2.51 | 1 | $75.30 |  | $0.00
26 | Micro USB | USB1 | USB - micro B USB 2.0 Receptacle Connector 5 Position Surface Mount, Right Angle | SMD | Flange, Horizontal | Amphenol FCI |  |  |  | $0.43 | 1 | $0.43 |  | $0.00
27 | CRYSTALECS-.327-12.5-12-C-TR (CRYSTAL) (32.7680kHz) | XTAL1 | 32.768kHz ±10ppm Crystal 12.5pF 90 kOhms 2-SMD, No Lead | SMD | 2-SMD, No Lead | ECS Inc. |  |  |  | $0.60 | 1 | $0.60 |  | $0.00
28 | CONN_07-1.27MM (CONN_07) | J2 | 50 Position Header Connector 0.050" (1.27mm) Through Hole Gold | THT |  | Sullins Connector Solutions |  |  |  | $5.06 | 1 | $5.06 |  | $0.00
29 | CONN_07-1.27MM | J2 | 50 Positions Header Connector 0.050" (1.27mm) Through Hole Gold | THT |  | Sullins Connector Solutions |  |  |  | $3.11 | 1 | $3.11 |  | $0.00
30 | 4.7k resistor | R4 | 4.7 kOhms ±1% 0.1W, 1/10W Chip Resistor 0603 (1608 Metric) Automotive AEC-Q200 Thick Film | SMD | 0603 | Stackpole Electronics Inc |  |  |  | $0.01 | 1 | $0.01 |  | $0.00
