Sayantanmukhuti/omni/(commit log)

2021-02-13 Today's work
    [Omni-BASIC-TOP.brd, Omni-BASIC-TOP.sch]
2021-02-20 commit operation
    [Omni-BASIC-BOTTOM.brd, Omni-BASIC-BOTTOM.sch, Omni-BASIC-TOP.brd, Omni-BASIC-TOP.sch]
2021-02-27 Latest Update
    [Omni-BASIC-BOTTOM.brd]
2021-03-20 End of class update
    [Omni-BASIC-TOP.brd]
2021-03-27 Update 2703-1
    [Omni-BASIC-TOP.brd, Omni-BASIC-TOP.sch]
2021-03-27 Fixed 1 of 2 airwires update
    [Omni-BASIC-TOP.brd]
2021-04-03 3rd April Update 1
    [Milestones-Exhaustive-BOM.xlsx, Omni-BASIC-BOTTOM-BOM.xlsx, Omni-BASIC-BOTTOM.brd, Omni-BASIC-BOTTOM.sch, Omni-BASIC-PPG-MODULE-BOM.xlsx, Omni-BASIC-PPG-MODULE.brd, Omni-BASIC-PPG-MODULE.sch, Omni-BASIC-TOP-BOM.xlsx]
